agentsamX/RacingMouse/ElectronicsInMouse.jpg

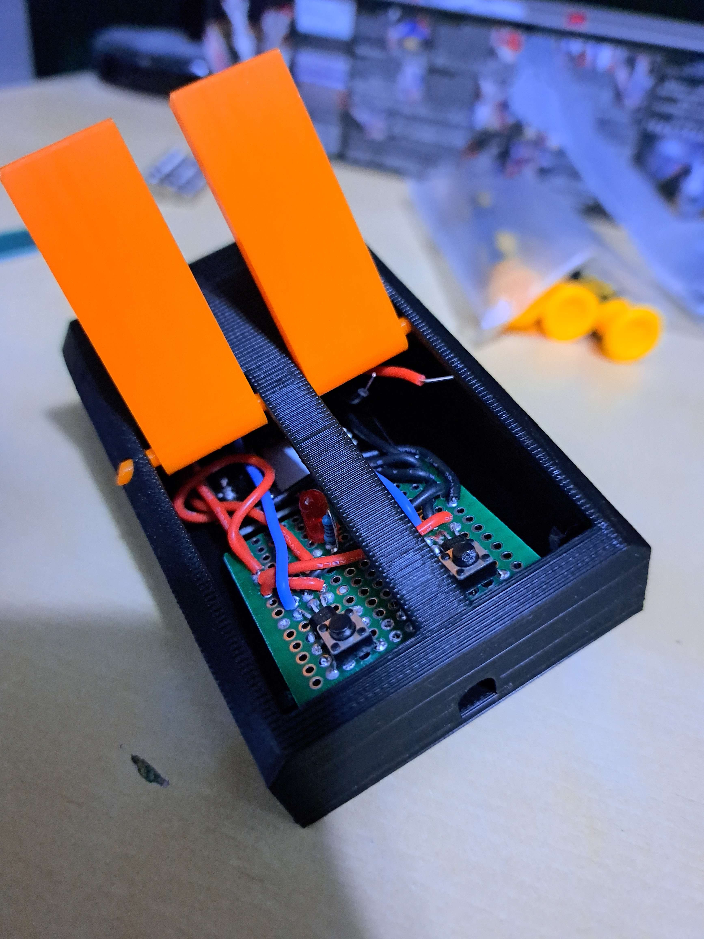
ElectronicsInMouse.jpg
