agentsamX/RacingMouse/20221128_214450.jpg

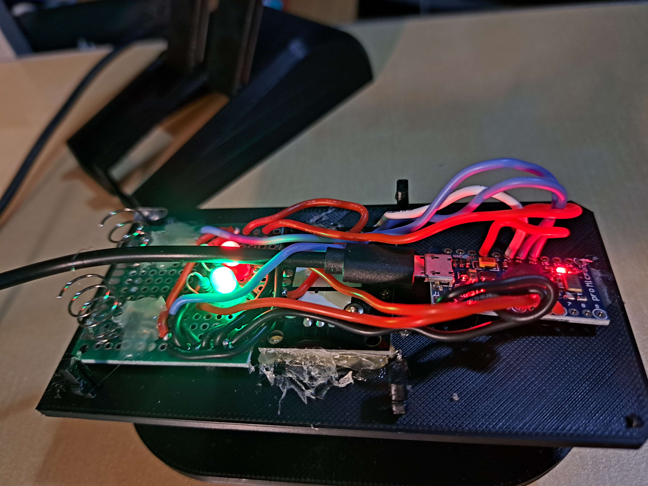
20221128_214450.jpg
