agentsamX/RacingMouse/README.md

# RacingMouse
<br>
Roles and responsibilities :
<br>
<br>
Harry Smith : Interactive scene design / component designer
<br>
<br>
Samuel Canonaco : Electronics / component designer
<br>
<br>
Course Project:
<br>
Link to electronics photo https://raw.githubusercontent.com/agentsamOTU/RacingMouse/main/20221128_214450.jpg
<br>
Link to electronics schematics https://raw.githubusercontent.com/agentsamOTU/RacingMouse/main/Screenshot_2022-11-29_204714.png
<br>
Our electronic components were soldered directly to a prototype board. The joystick and prototype board both had slots to fit into modelled on our bottom piece. In addition, the joystick, prototype board, and arduino were all hot glued to the base as well. For Wire Management we mostly had to worry about wires getting in the way of our buttons. We were able to route any wires on that side of the board through our middle channel. Additionally, the use of solid core wire allowed us to more reliably shape our wires' paths.
<br>
Link to written report https://github.com/agentsamOTU/RacingMouse/blob/main/INFR_3380U__Industrial_Design_for_Game_Hardware_Written_Report.pdf
<br>
Link to timeline image https://github.com/agentsamOTU/RacingMouse/blob/main/INFR_3380U__Industrial_Design_for_Game_Hardware_Written_Report.pdf
<br>
Link to exploded view animation https://youtu.be/0zIDtcym9Jo
<br>
Link to presentation video https://youtu.be/VZlyi0CGqh0
<br>
Link to QFD https://github.com/agentsamOTU/RacingMouse/blob/main/QFD_EON.pdf
<br>
Link to SUS https://github.com/agentsamOTU/RacingMouse/blob/main/SUS%20Scale.pdf
<br>
Link to interactive controller demonstration https://youtu.be/6uBp4vRtQWE
<br>
This video features the RacingMouse being used in the commercial video game Drift21. The game features a test course that the player can drift around using the controller and a keyboard. Its purpose is to test your skills before you move onto actual timed races. The controller has inputs for acceleration, braking, and steering. Compared to using a typical mouse in your right hand, this controller gives a much more precise feeling experience. It allows the PC player to actually have sufficient levels of control over their car, while still retaining access to a keyboard. Additionally, the mouse has two leds that increase in brightness as the accelerate and brake buttons are pushed further down.
