agentsamX/RacingMouse/ProgressRolesContributions.pdf

Progression, Roles and contributions Progress
- Creation of near final layout and model
- Almost all necessary components purchased
- Completion of near final circuit diagram
- Printed prototypes to test ergonomic functionality
- Technical drawings for every fabricated component

Harrison Smith - 100744645 - technical writer, parts designer
- Creation of technical drawings as well as bill of materials
- Creation of exploded view animation as well as technical drawing
- Aided in creation of small parts for the overall design
- Provided feedback on physical prototype for design

Samuel Canonaco - 100742837 - Programming and Cad Modeling
- Creation of main components in assembly
- Creation of circuit diagram resembling final circuit
- Created layout of electronic components in model
