agentsamX/RacingMouse/Schematics/ElectronicsSchematic.pdf

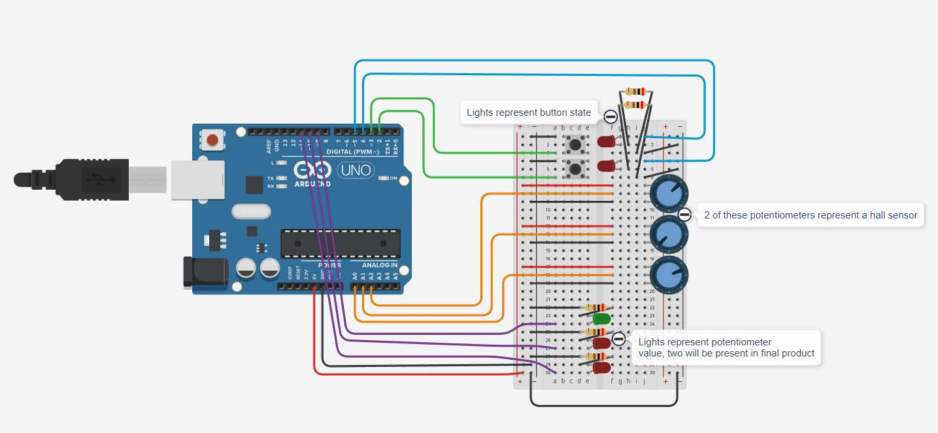
[picture p4: page 1]
