agentsamX/RacingMouse/GanttChart.pdf

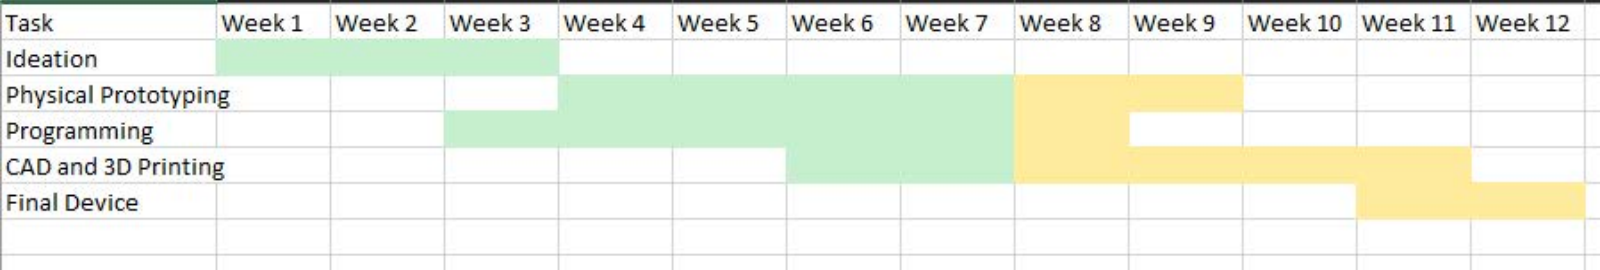
[picture p5: page 1]
