agentsamX/RacingMouse/PrototypePhotos/20221017_221656.jpg

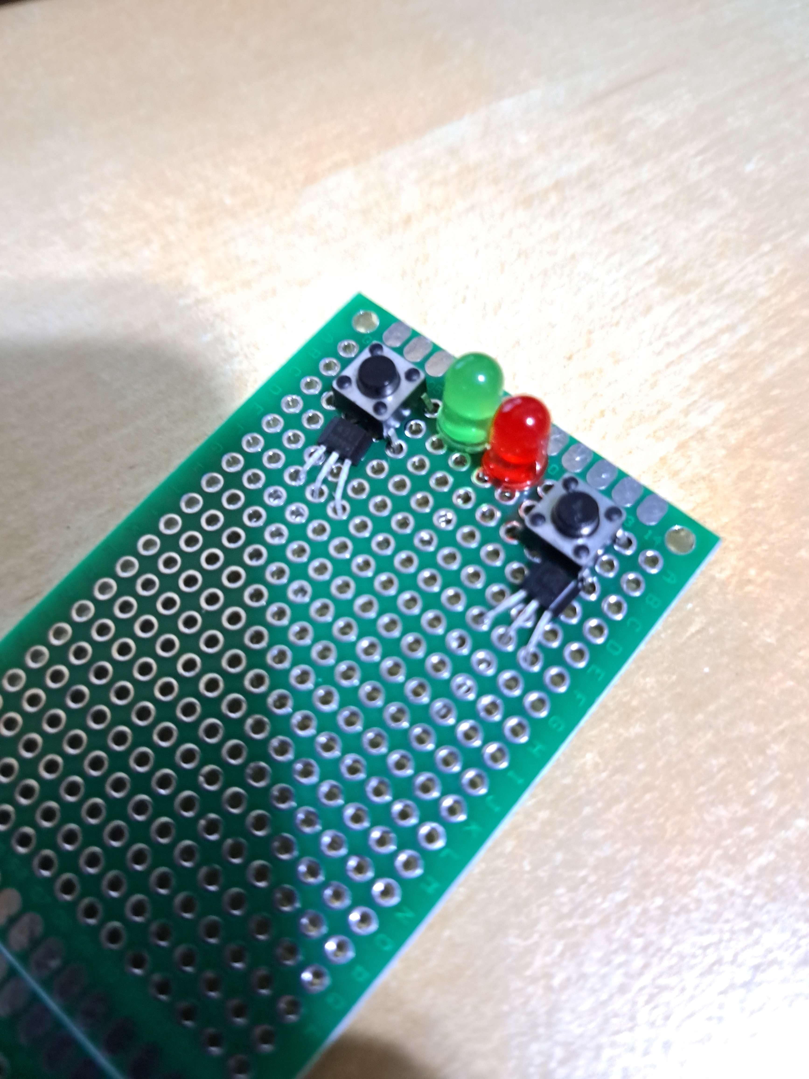
PrototypePhotos/20221017_221656.jpg
