agentsamX/RacingMouse/PrototypePhotos/20221025_092342.jpg

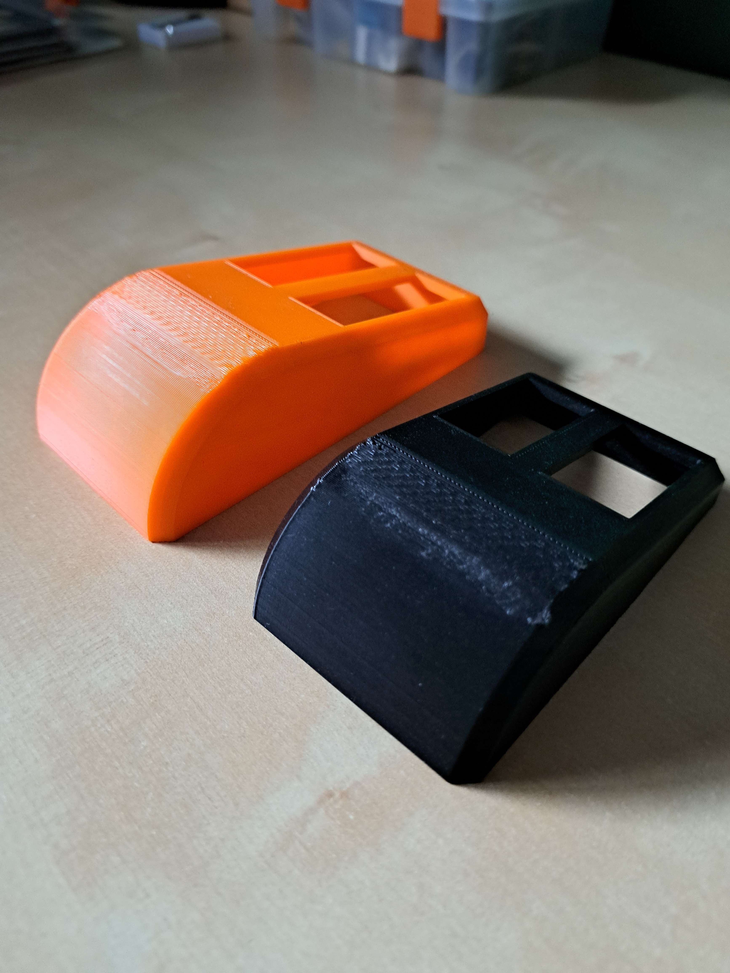
PrototypePhotos/20221025_092342.jpg
