agentsamX/RacingMouse/Racing Mouse Timeline.png

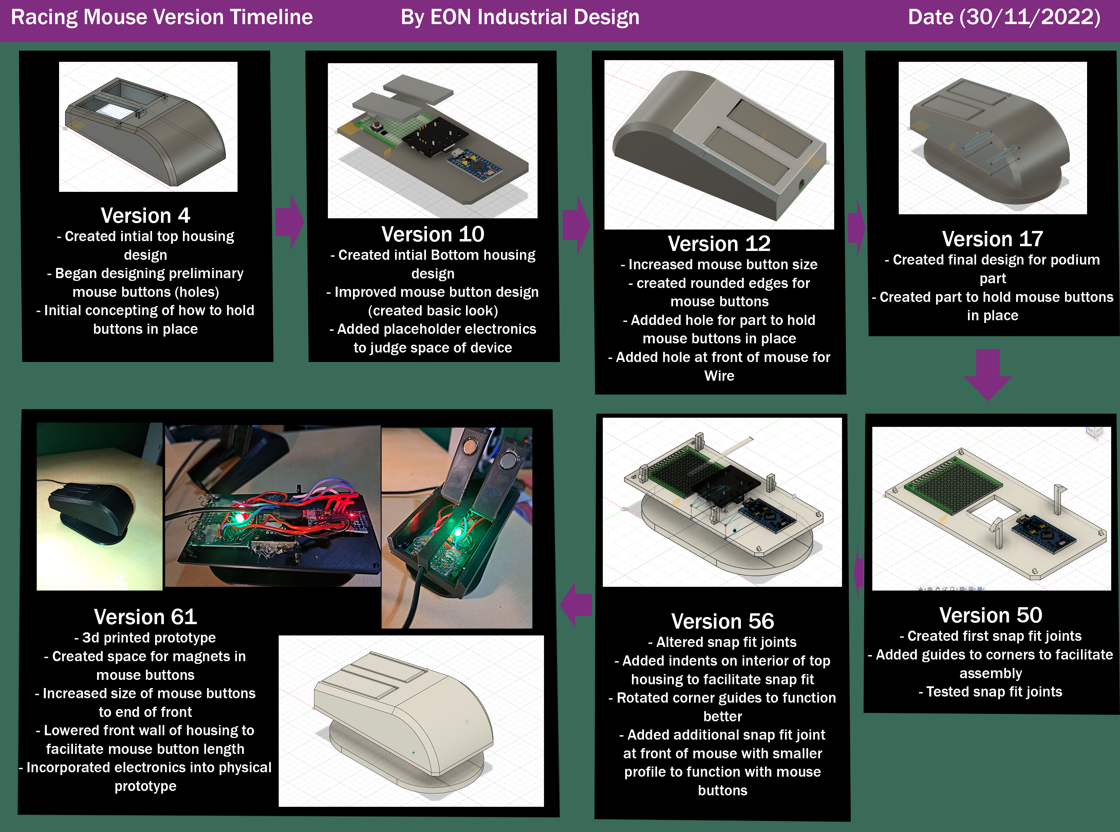
Racing Mouse Timeline.png
