agentsamX/RacingMouse/Screenshot_2022-11-29_204714.png

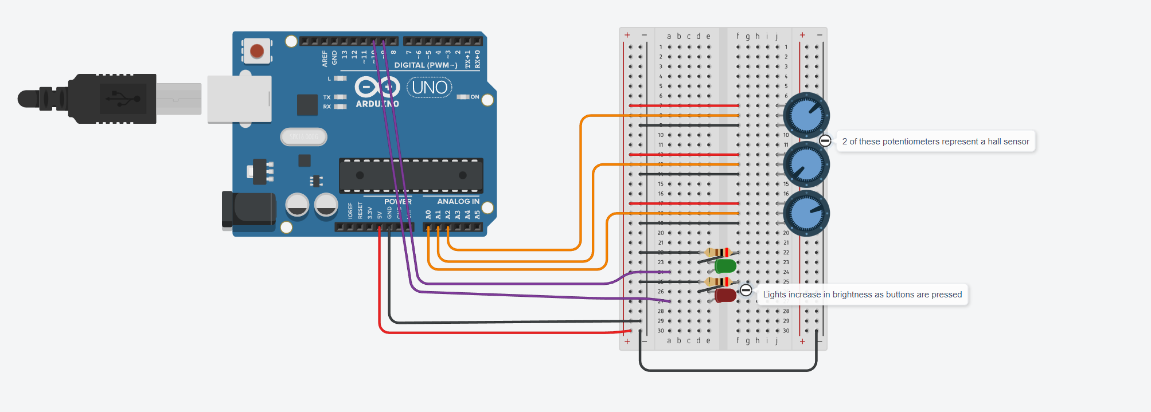
Screenshot_2022-11-29_204714.png
