agentsamX/RacingMouse/3DPrintedPartTimesAndCost.xlsx

Part | Quantity | Print Time | Print Weight(g)
MouseTop | 1 | 6:52:00 | 41 | Filament Cost | 29.99
MouseBottom | 1 | 2:08:00 | 17 | Filament Weight(g) | 1000
Podium | 1 | 2:47:00 | 25 | FIlament Type | PLA+
MouseButton | 2 | 0:29:00 | 3
Rod | 1 | 0:08:00 | 0.5
Total |  | 12:53:00 | 89.5
 |  |  | $2.68
