agentsamX/RacingMouse/Schematics/ProtoMouseLong_Mouse_button.pdf

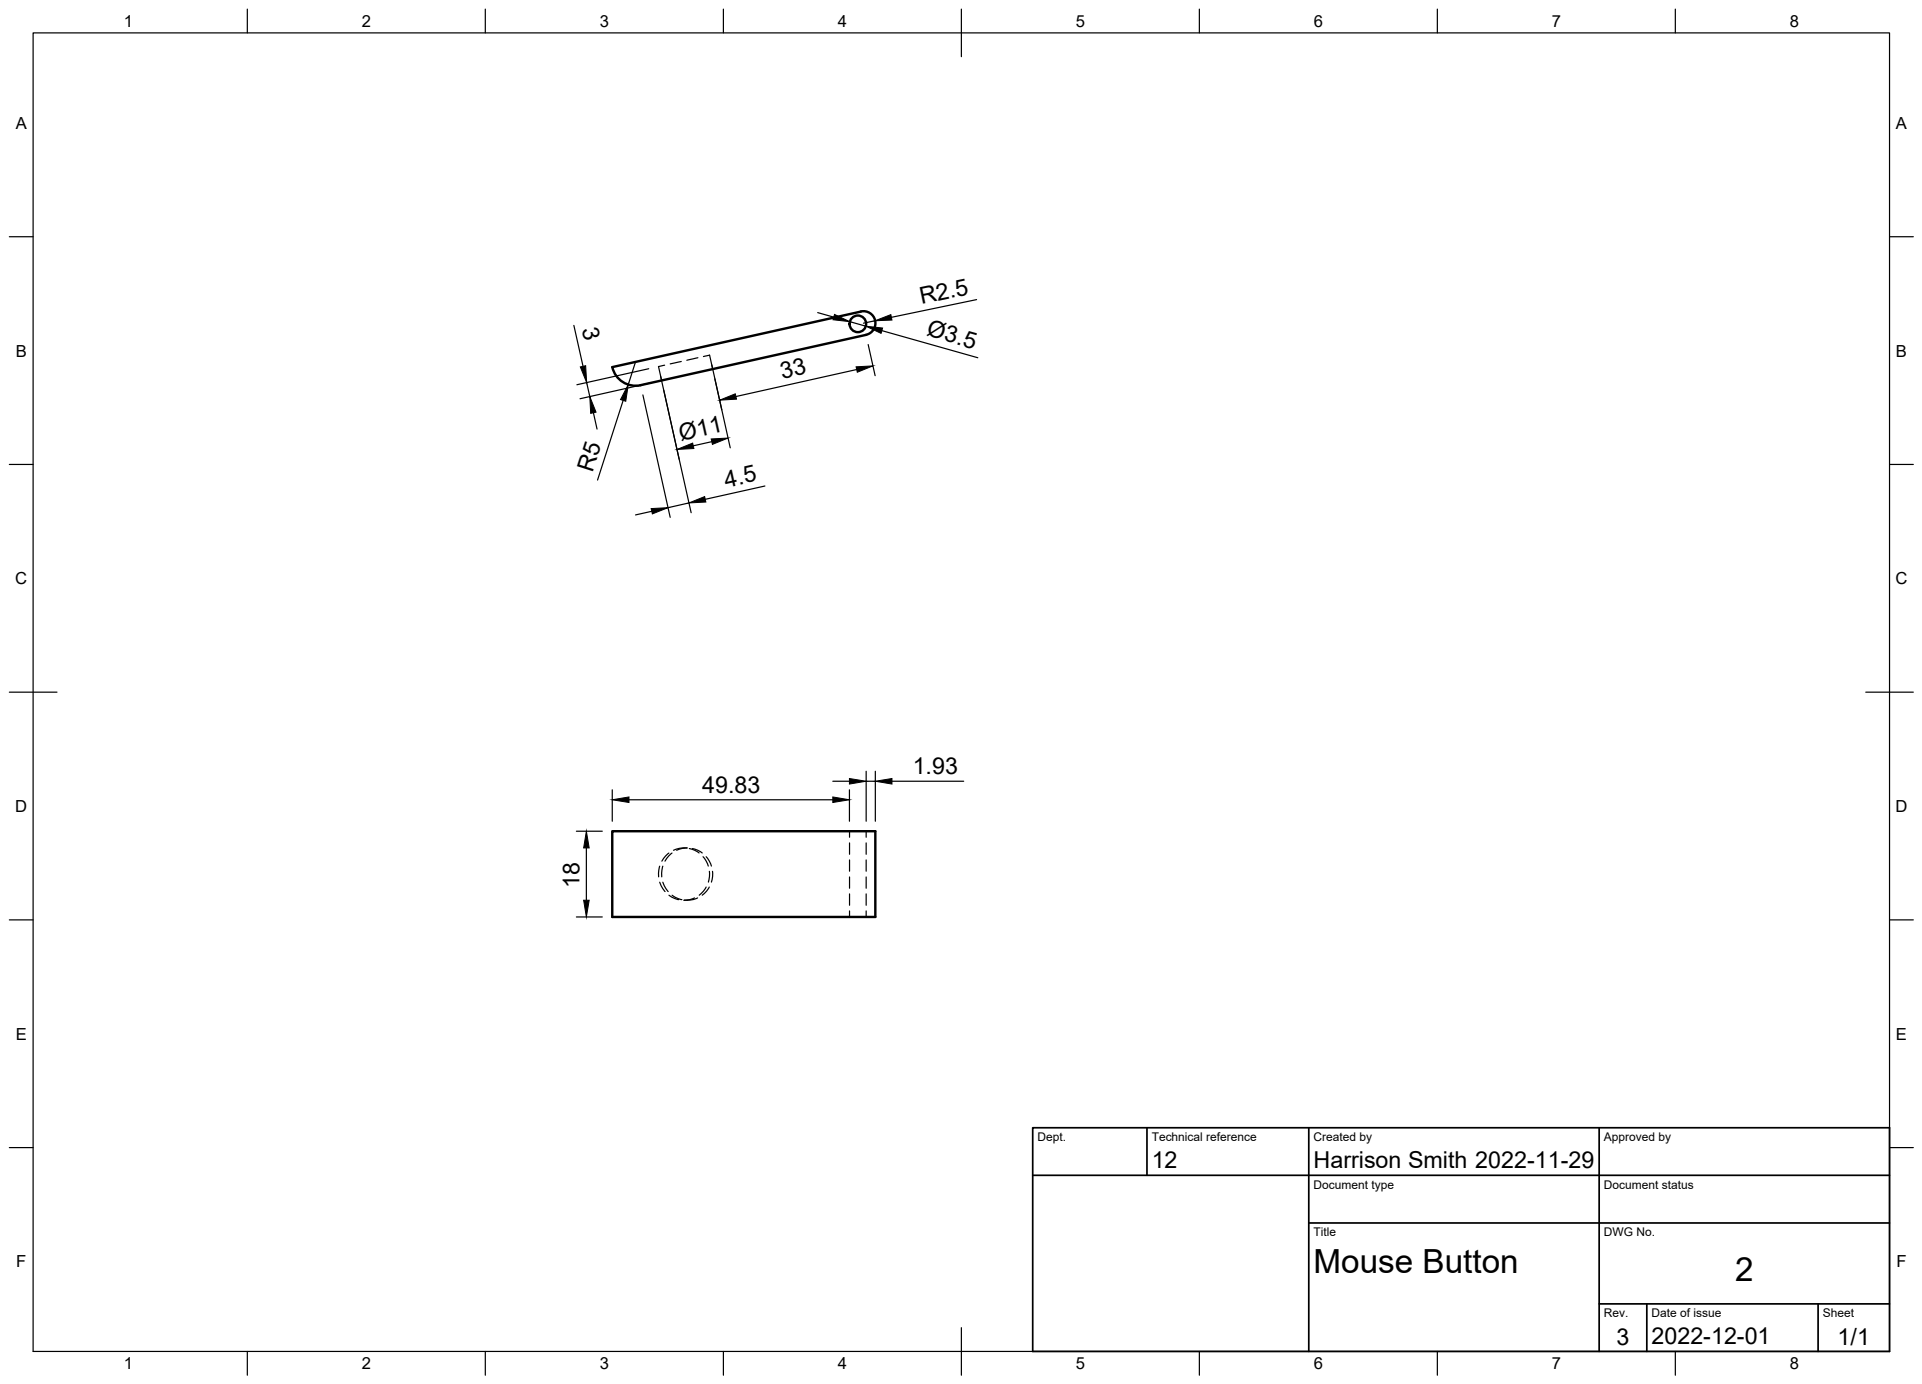
[picture p10: page 1]
Title; DWG No.; Rev.; Date of issue; Sheet; Mouse Button

Dept. | Technical reference 12 | Created by Harrison Smith 2022-11-29 | Approved by

Document type | Document status
