agentsamX/RacingMouse/Schematics/ProtoMouseLong_Bottom_housing.pdf

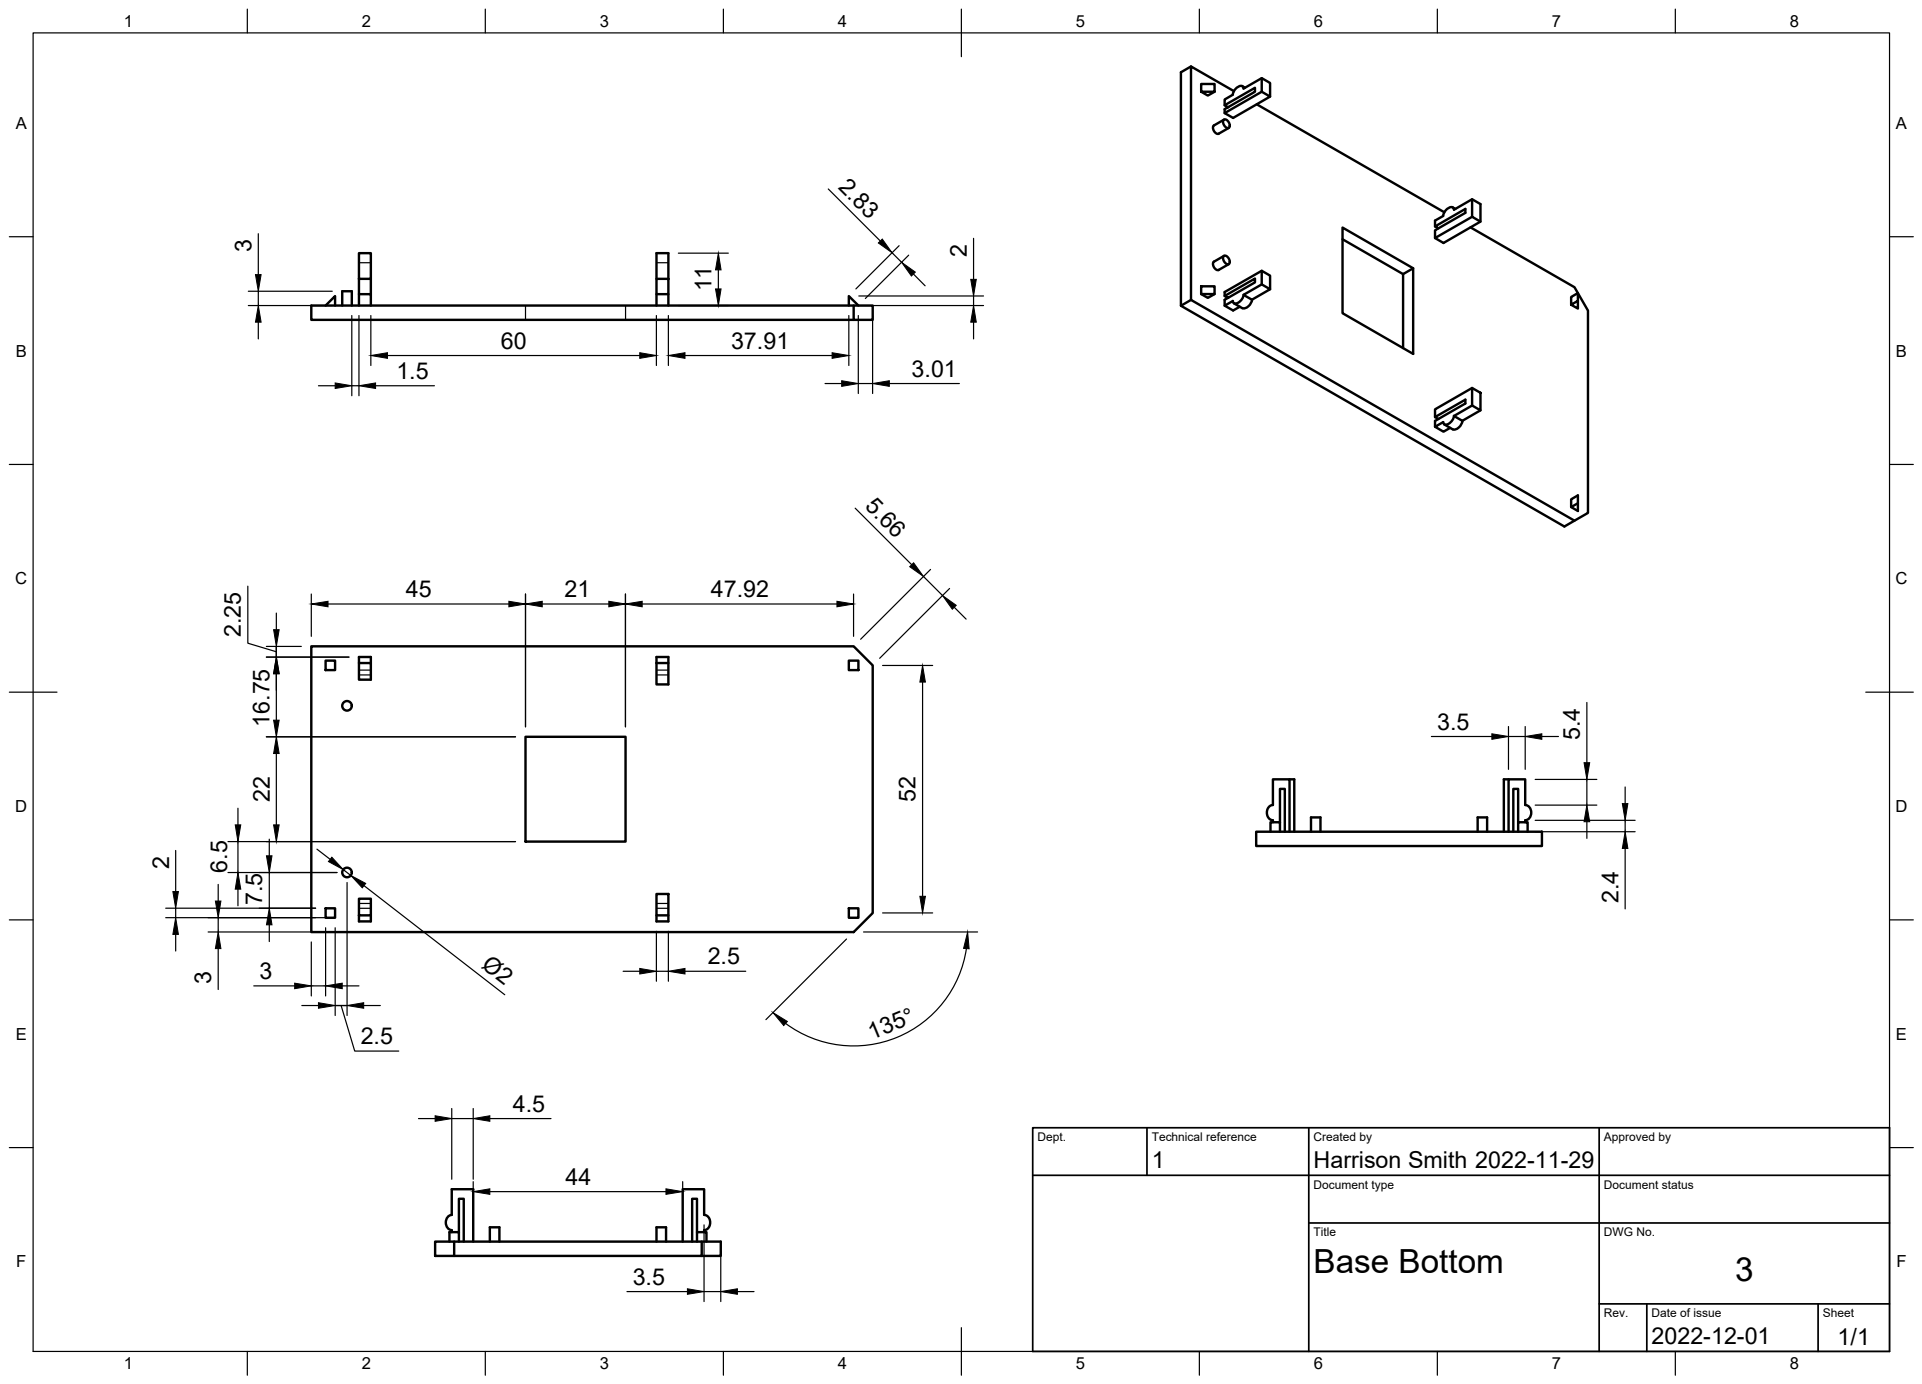
[picture p11: page 1]
Title; DWG No.; Rev.; Date of issue; Sheet; Base Bottom

Dept. | Technical reference 1 | Created by Harrison Smith 2022-11-29 | Approved by

Document type | Document status
