agentsamX/RacingMouse/Schematics/ProtoMouseLong_Top_Housing.pdf

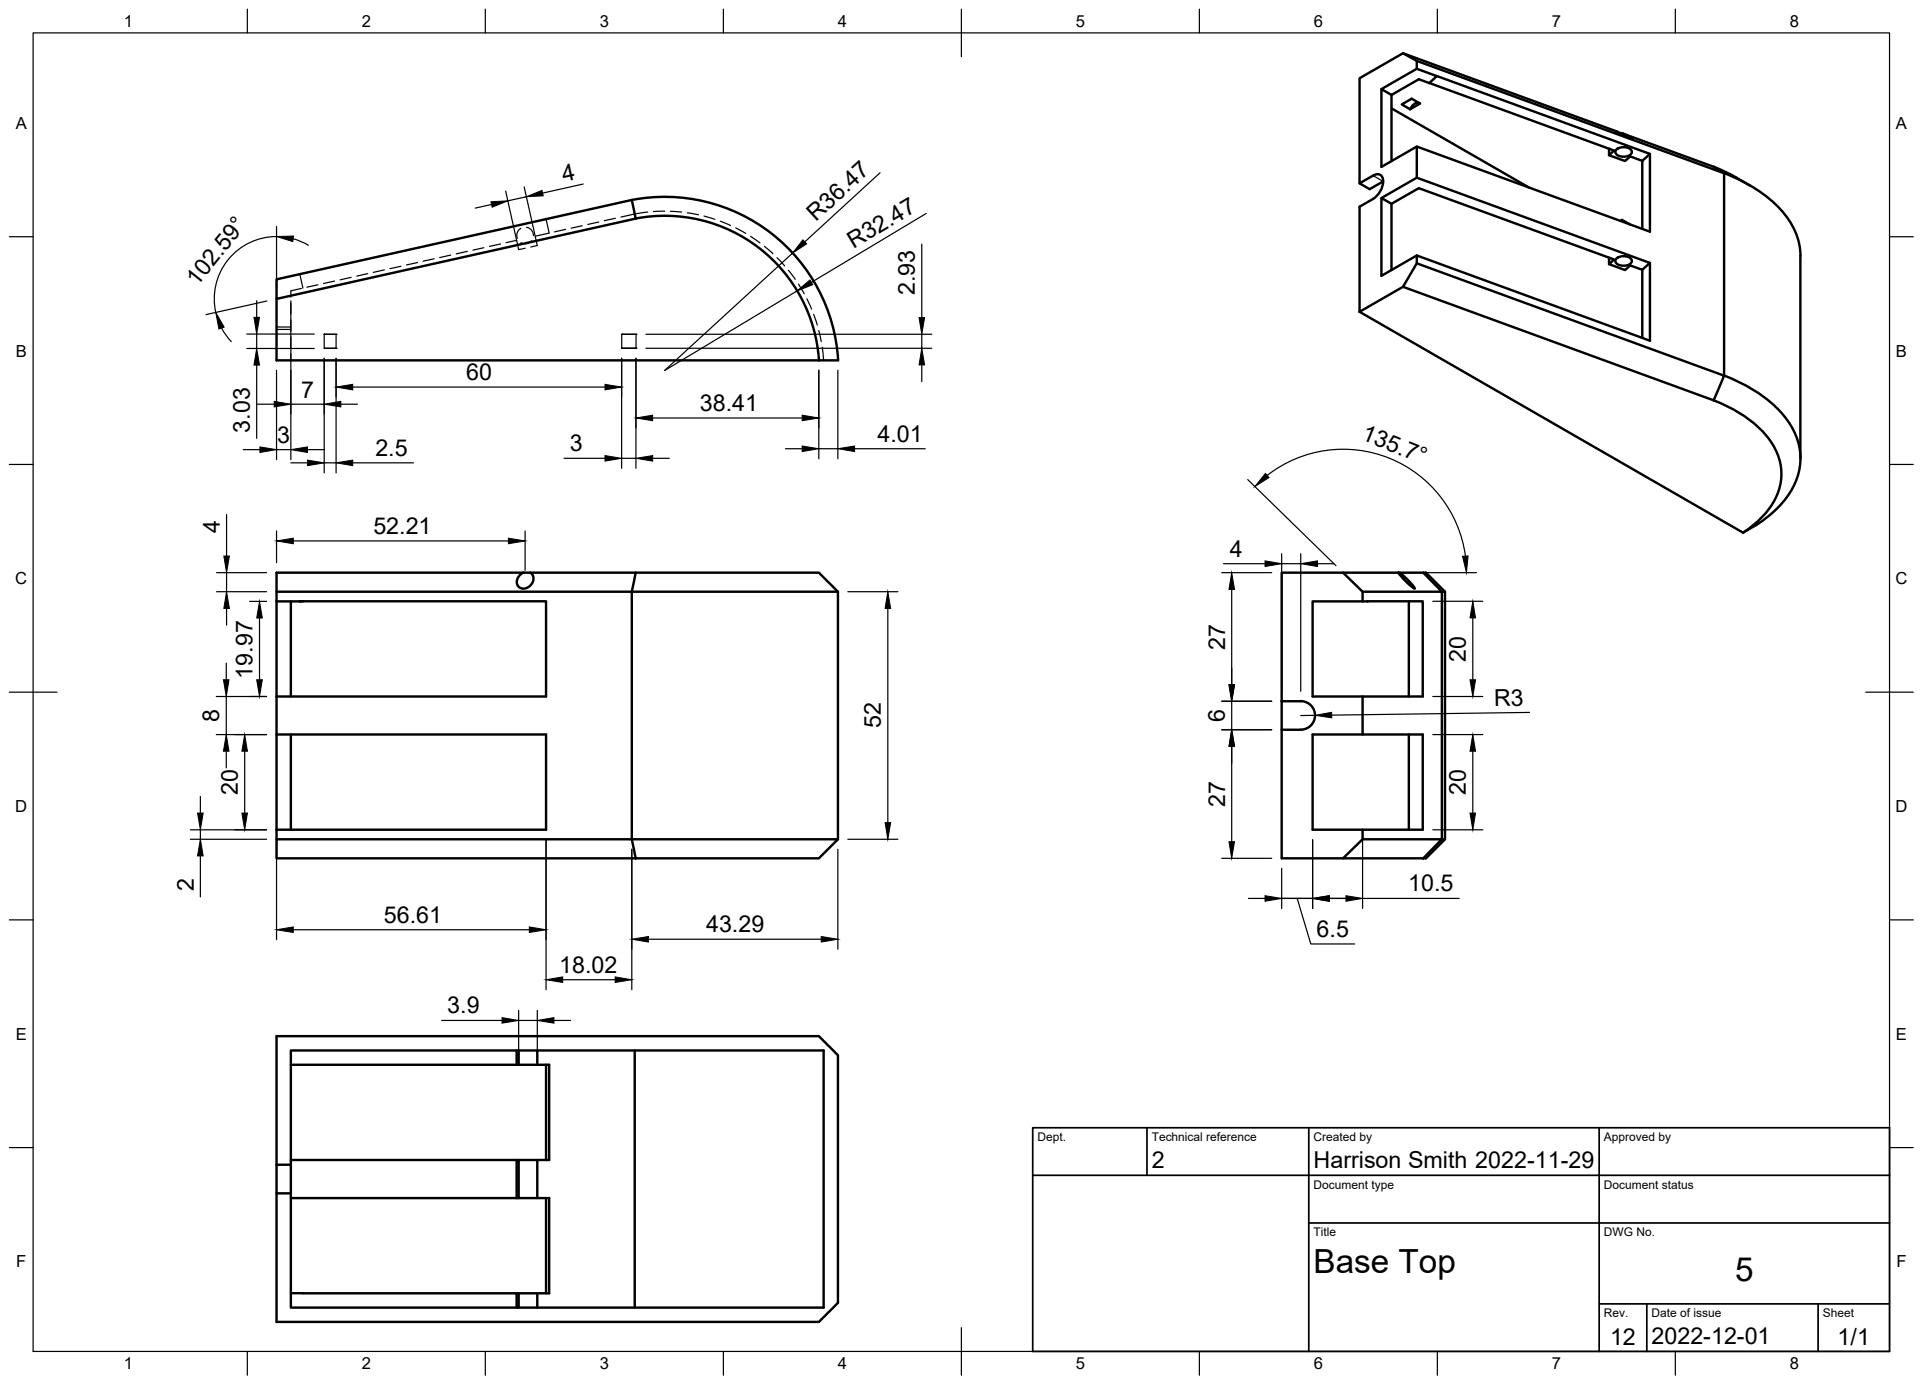
[picture p12: page 1]
Title; DWG No.; Rev.; Date of issue; Sheet; Base Top; Harrison Smith 52

Dept. | Technical reference | Created by 2022-11-29 | Approved by

Document type | Document status
