agentsamX/RacingMouse/Schematics/Podium Dimensions v15.pdf

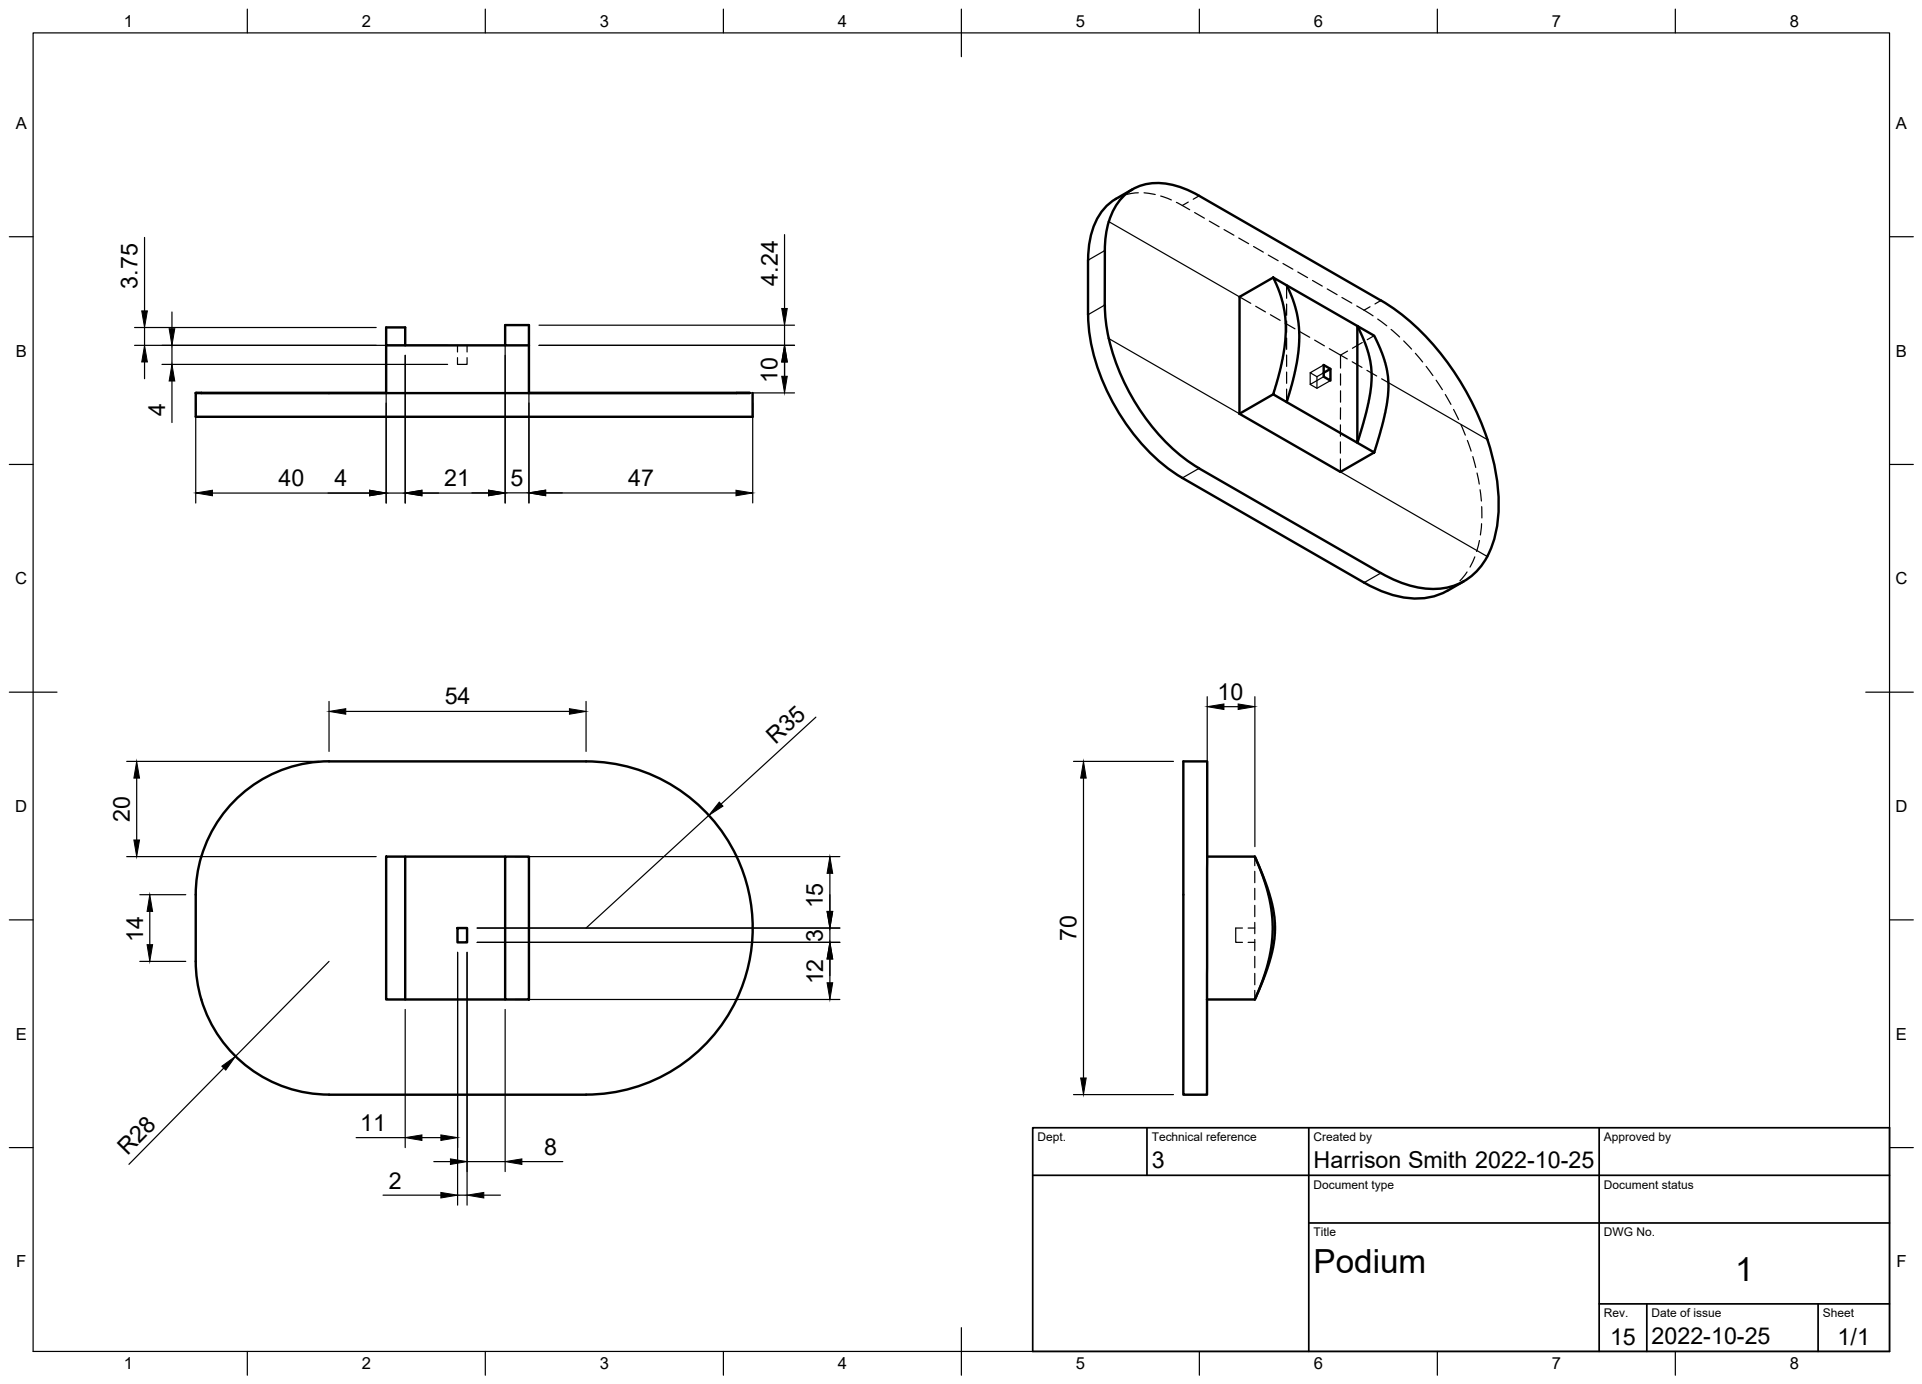
[picture p13: page 1]
Title; DWG No.; Rev.; Date of issue; Sheet

Dept. | Technical reference 3 | Created by Harrison Smith 2022-10-25 | Approved by

Document type | Document status
