agentsamX/RacingMouse/Schematics/Rod Dimension v8.pdf

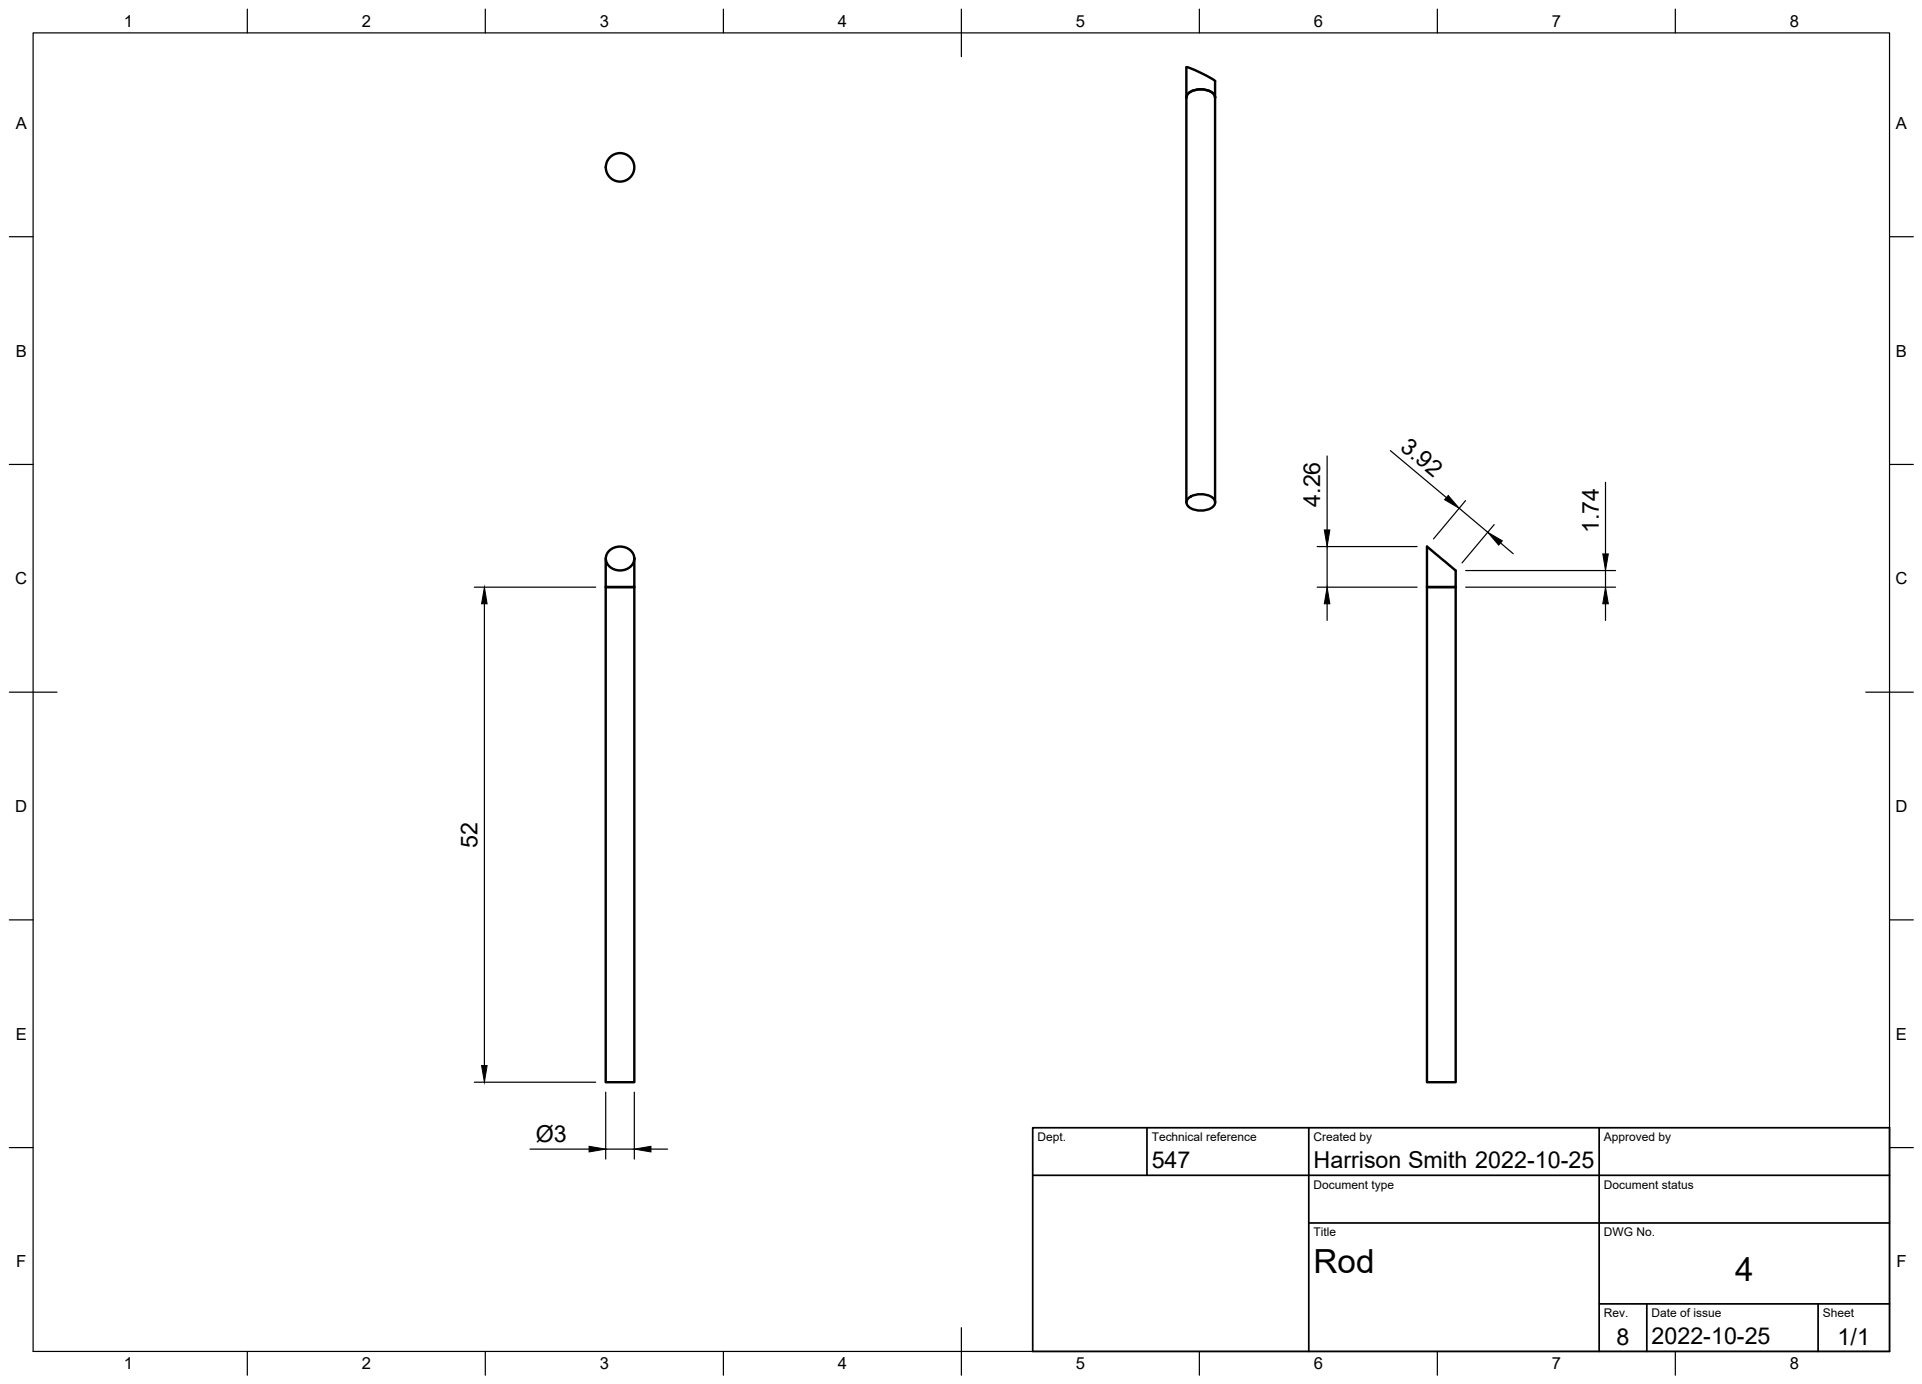
[picture p14: page 1]
Title; DWG No.; Rev.; Date of issue; Sheet; Harrison Smith 52

Dept. | Technical reference | Created by 2022-10-25 | Approved by

Document type | Document status
