agentsamX/RacingMouse/QFD_EON.pdf

## QFD: House of Quality

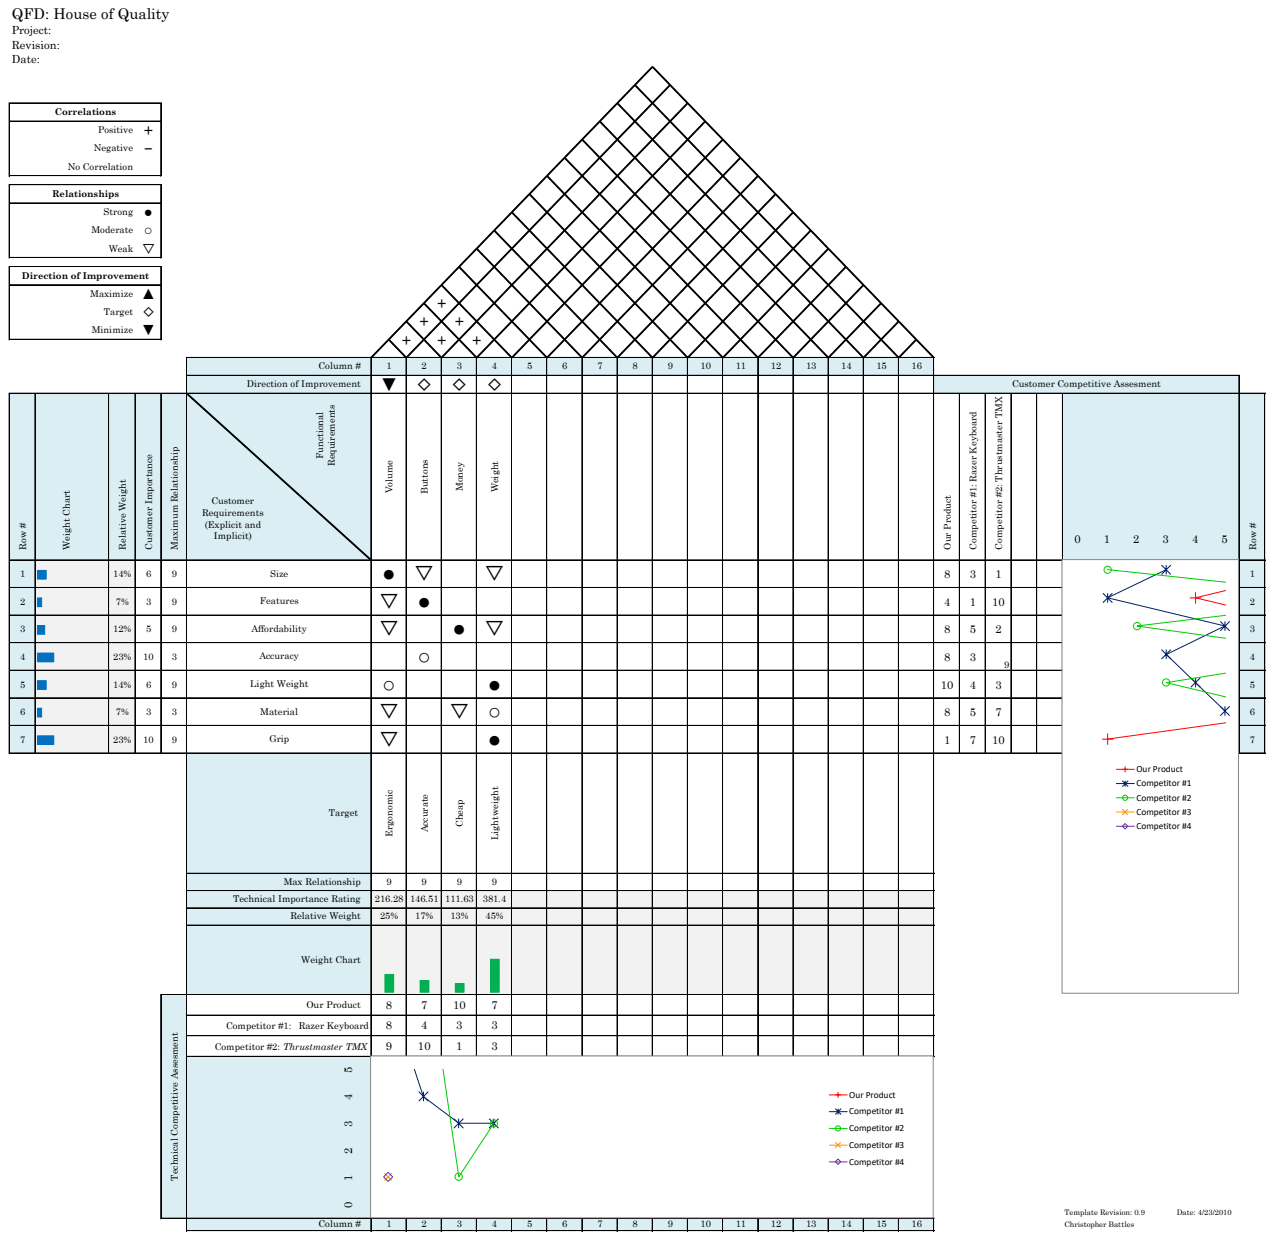
[picture p15: page 1]
Project: Revision: Date:; Functional; Requirements; Christopher Battles; Volume; Buttons; Money; Weight; Row #; Weight Chart; Relative Weight; Customer Importance; Ergonomic; Accurate; Cheap; Lightweight; Column #; Maximize; Target; Minimize; Correlations; Positive; Negative; No Correlation; Relationships; Strong; Moderate; Weak ▽; Our Product; Template Revision: 0.9; Date: 4/23/2010; Maximum Relationship; Competitor #1; Competitor #2; Competitor #3; Competitor #4

Direction of Improvement

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

Direction of Improvement | ▼ | ◇ | ◇ | ◇ | | | | | | | | | | | | | Customer Competitive Assesment

Competitor #2: Thrustmaster TMX

Competitor #1: Razer Keyboard

Customer Requirements (Explicit and Implicit) | | | | | | | | | | | | | | | | 0 1 2 3 4 5

1 | |||||| | 14% | 6 | 9 | Size | ● | ▽ | | ▽ | | | | | | | | | 8 | 3 | 1 | | 1

2 | ||| | 7% | 3 | 9 | Features | ▽ | ● | | | | | | | | | | | 4 | 1 | 10 | | 2

3 | ||||| | 12% | 5 | 9 | Affordability | ▽ | | ● | ▽ | | | | | | | | | 8 | 5 | 2 | | 3

4 | ||||||||||| | 23% | 10 | 3 | Accuracy | | ○ | | | | | | | | | | | 8 | 3 | 9 | | 4

5 | |||||| | 14% | 6 | 9 | Light Weight | ○ | | | ● | | | | | | | | | 10 | 4 | 3 | | 5

6 | ||| | 7% | 3 | 3 | Material | ▽ | | ▽ | ○ | | | | | | | | | 8 | 5 | 7 | | 6

7 | ||||||||||| | 23% | 10 | 9 | Grip | ▽ | | | ● | | | | | | | | | 1 | 7 | 10 | | 7

Target

Max Relationship | 9 | 9 | 9 | 9

Technical Importance Rating

Weight Chart | 216.28 | 146.51 |||||||| | 111.63 |||||| | 381.4

Relative Weight | 25% | 17% | 13% | 45%

Our Product | 8 | 7 | 10 | 7

Competitor #1: Razer Keyboard | 8 | 4 | 3 | 3

Technical Competitive Assesment

Competitor #2: Thrustmaster TMX | 9 | 10 | 1 | 3
